blackspiderrr/GestureRecognition/README.md

# Gesture Recognition based on STM32G0 Microcontroller and 16 ITR20001/T24 Infrared Sensors
## Intro
- This is about the design process of the course project in 'Comprehensive Design and Practice A' at Tongji.  
- This course design covers circuit schematic design, PCB layout, K-Means algorithm clustering, embedded language development, etc., 
so that the gesture recognizer can sense the rock✊, scissors✌, and paper✋ gestures placed close to the PCB, and display the judgment results in the form of LED lights.  
- You can also find more details in the Report.  

## Demo
<div align=center>
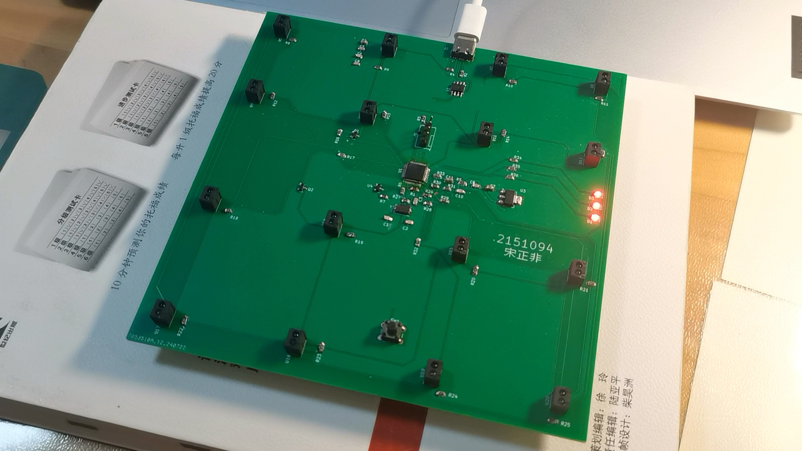
[picture p1: Image/Test0_Nothing.jpg]
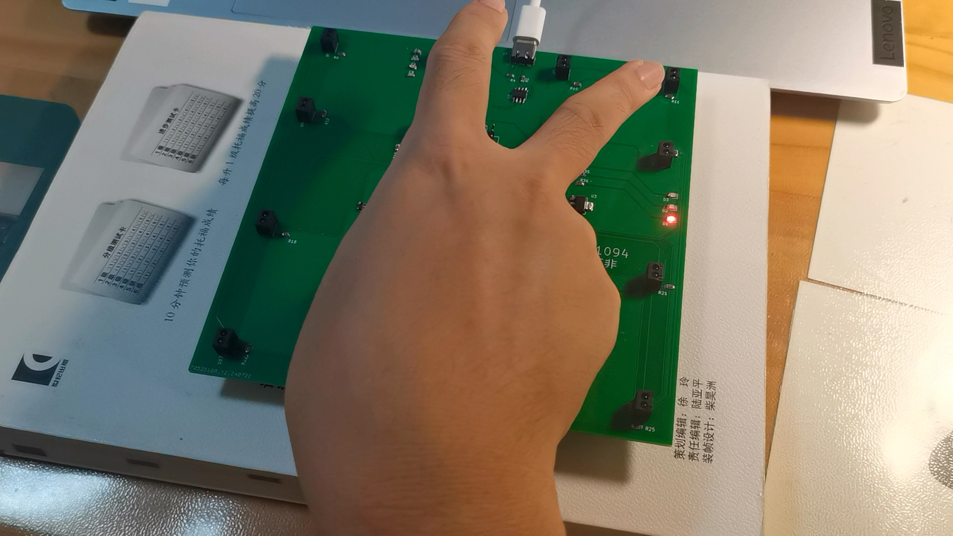
[picture p2: Image/Test1_S.jpg]
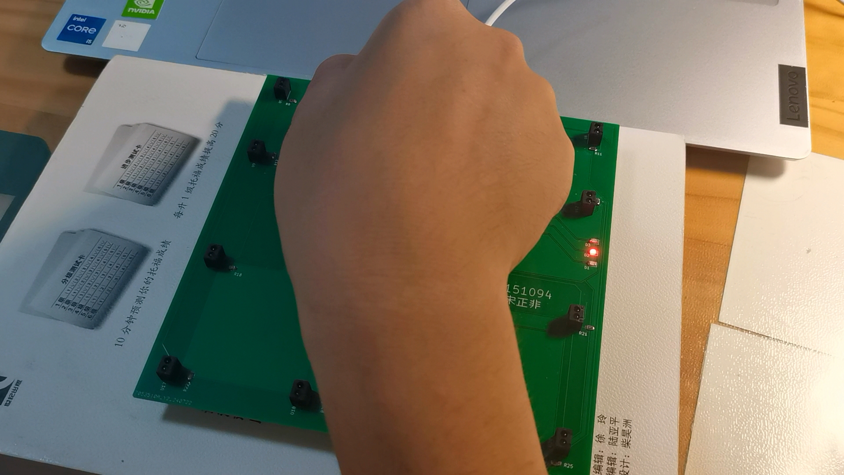
[picture p3: Image/Test2_R.jpg]
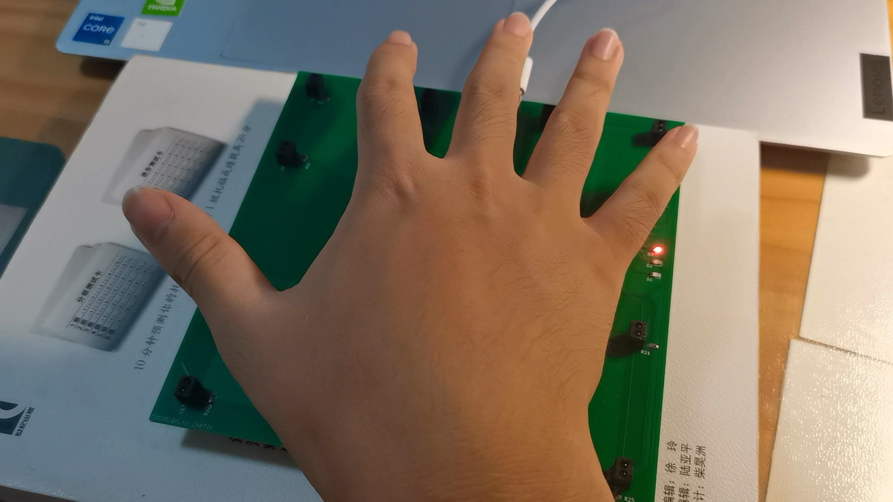
[picture p4: Image/Test3_P.jpg]
   
</div>

## Design Process
### Circuit Schematic Design
- Use KiCad  
- Design:
<div align=center>
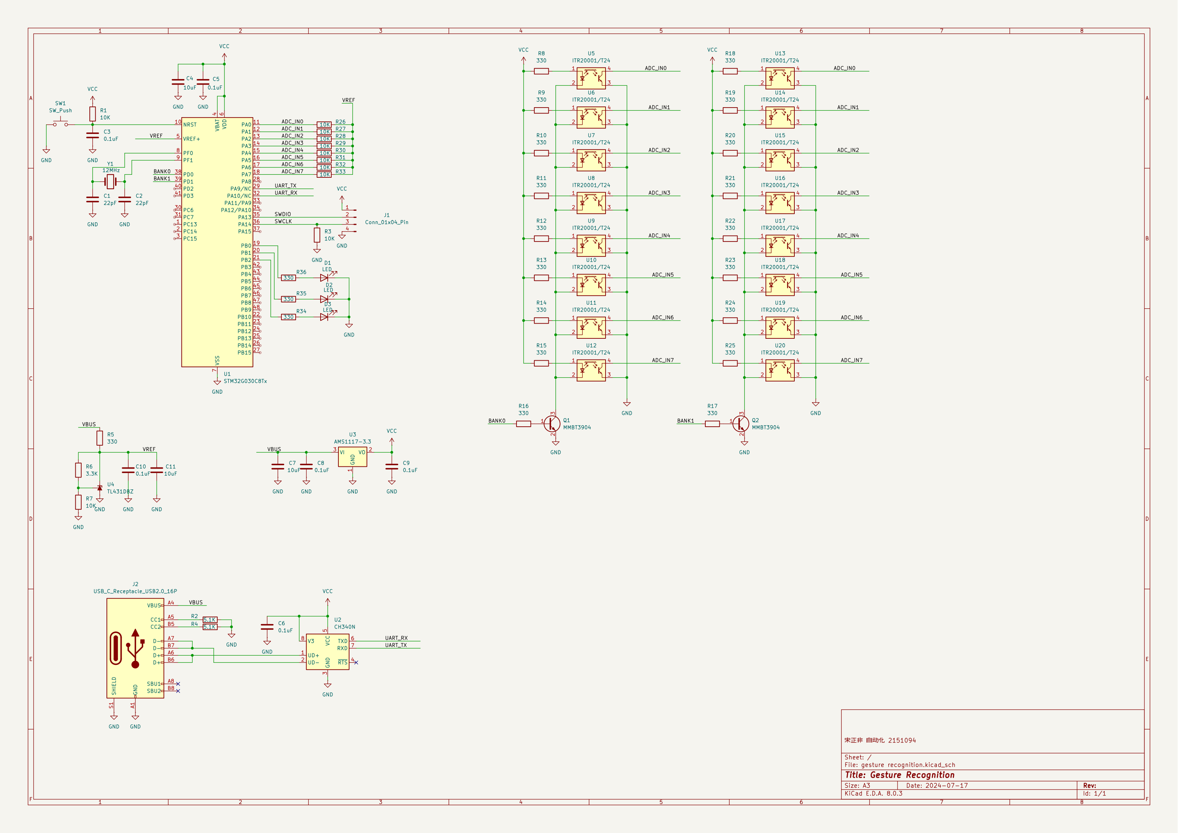
[picture p5: Image/CircuitDiagram.png]

</div>

### PCB layout
- Use KiCad
- Design:  
<div align=center>
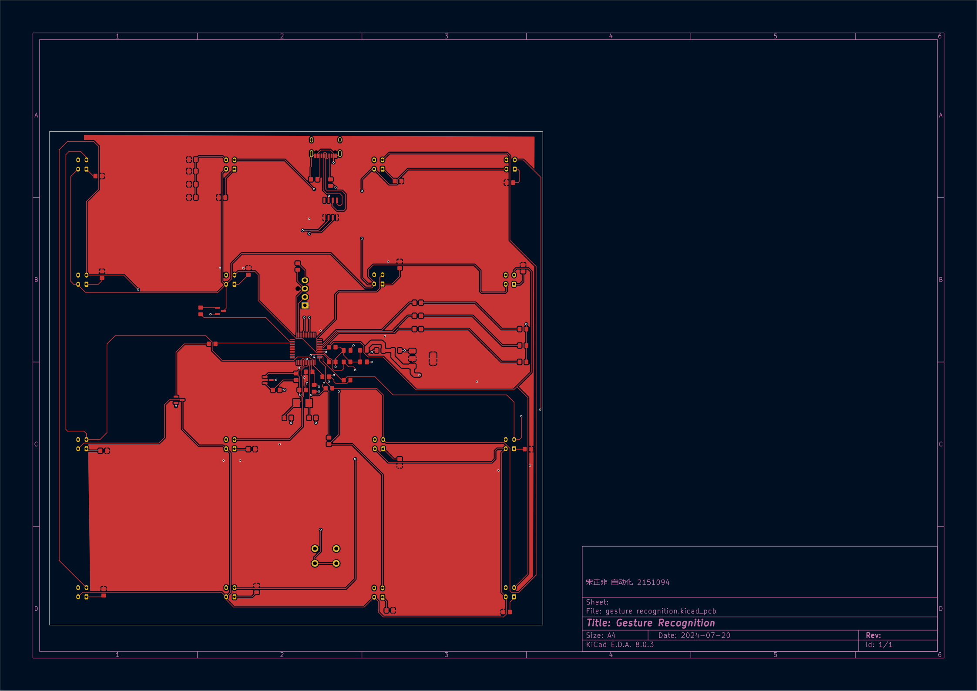
[picture p6: Image/PCB1.png]
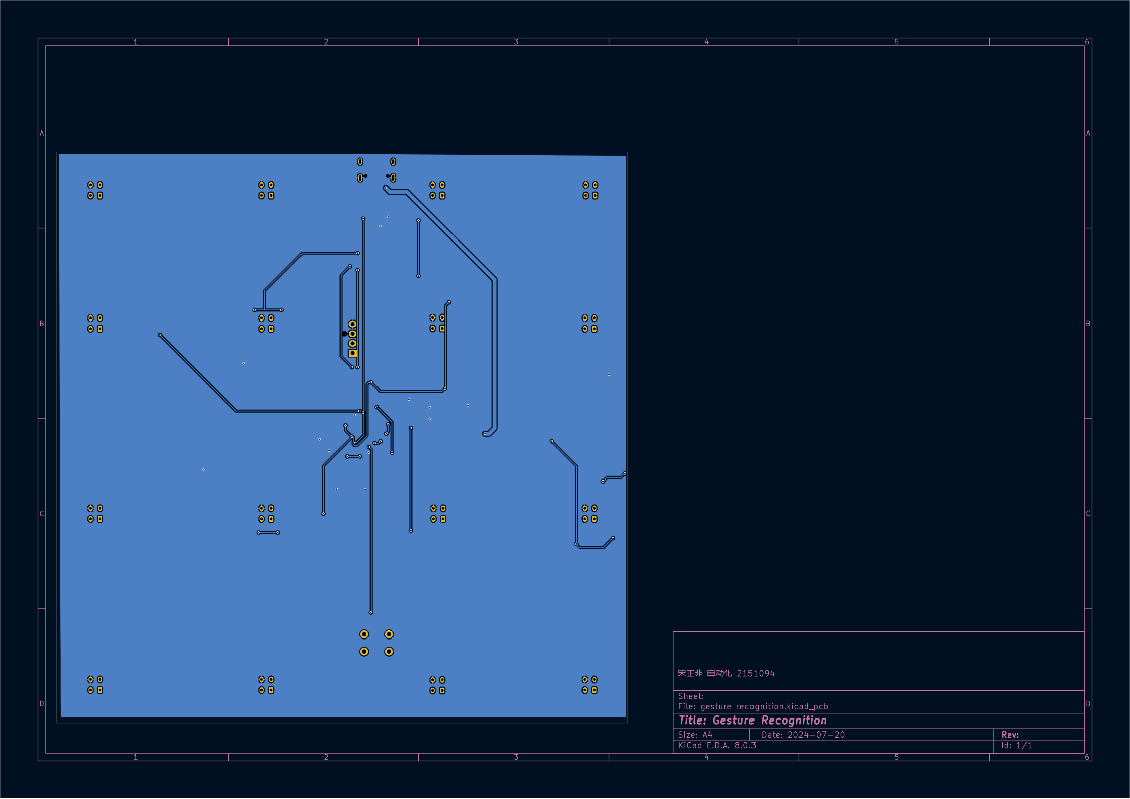
[picture p7: Image/PCB2.png]
 
</div>  

- 3D Model:  
<div align=center>
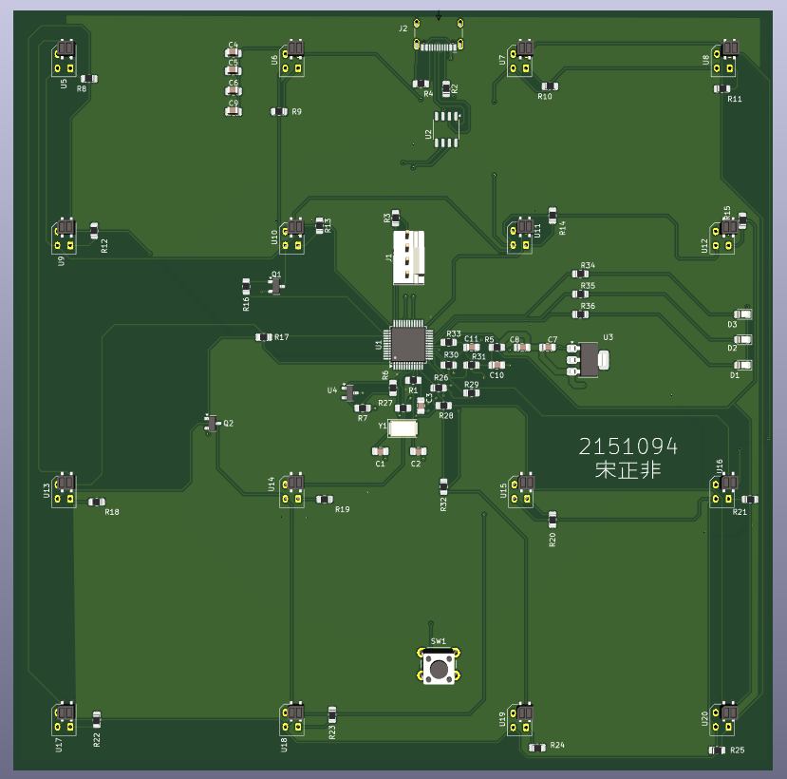
[picture p8: Image/3D.png]

</div>

### Welding and Collecting Data
<div align=center>
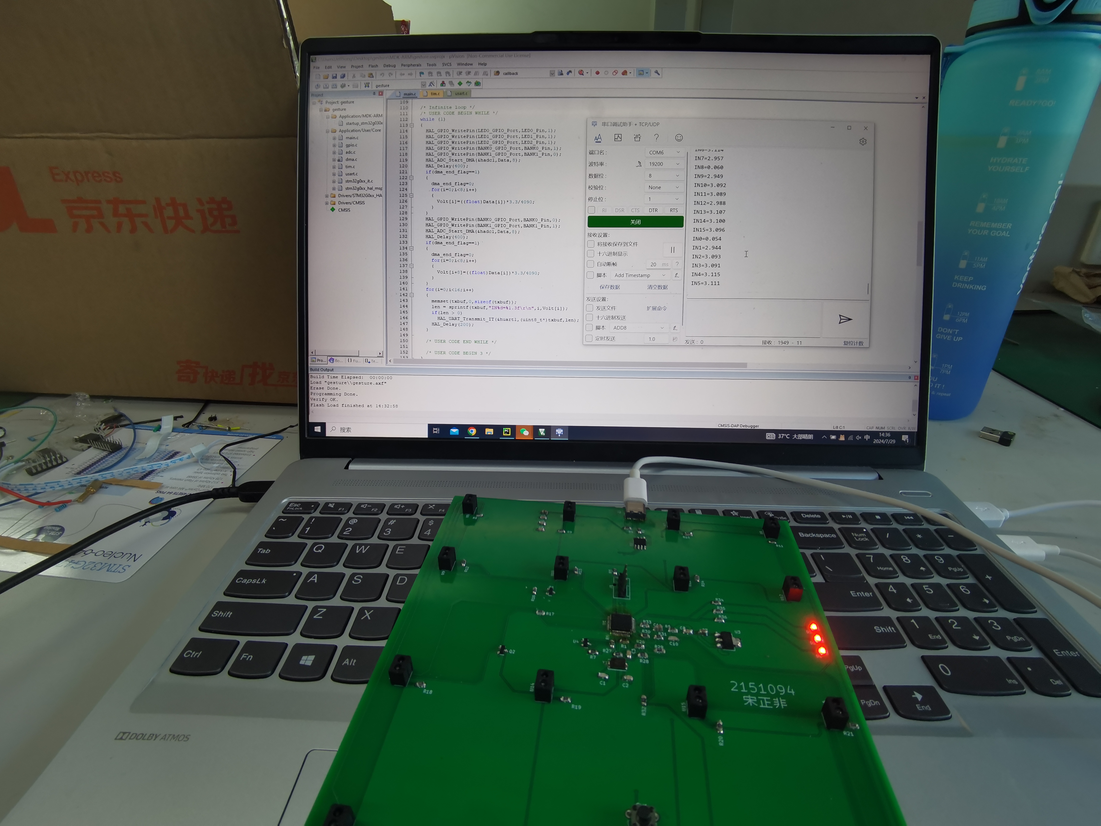
[picture p9: Image/Collecting.jpg]

</div>
  
### K-Means Clustering Algorithm
- 16-dimensional clustering  
- Look at Folder ‘K-Means’ for more details.  

### Embedded System Development
- Folder 'gesture' is about PC-side training and reasoning, and then pushing result to the board to display (by modifying code about LED).
- Folder 'gesture (2)' is about PC-side training and MCU-side reasoning and display.

## Limitation
- The infrared sensors are not very sensitive, so detection needs to be within a certain distance range.
- LED display has delay, and the interactive effect needs to be improved.
