blackspiderrr/GestureRecognition/gesture (2)/gesture.ioc

Mcu.UserName=STM32G030C8Tx
PA0.Signal=ADC1_IN0
PA1.Signal=ADC1_IN1
PA10.Signal=USART1_RX
PA13.Signal=SYS_SWDIO
PA14-BOOT0.Signal=SYS_SWCLK
PA2.Signal=ADC1_IN2
PA3.Signal=ADC1_IN3
PA4.Signal=ADC1_IN4
PA5.Signal=ADC1_IN5
PA6.Signal=ADC1_IN6
PA7.Signal=ADC1_IN7
PA9.Signal=USART1_TX
PB0.GPIO_Label=LED0
PB0.Signal=GPIO_Output
PB1.GPIO_Label=LED1
PB1.Signal=GPIO_Output
PB2.GPIO_Label=LED2
PB2.Signal=GPIO_Output
PD0.GPIO_Label=BANK0
PD0.Signal=GPIO_Output
PD1.GPIO_Label=BANK1
PD1.Signal=GPIO_Output
